ospringauf/espfan/fancontrol/wiring-diagram.png

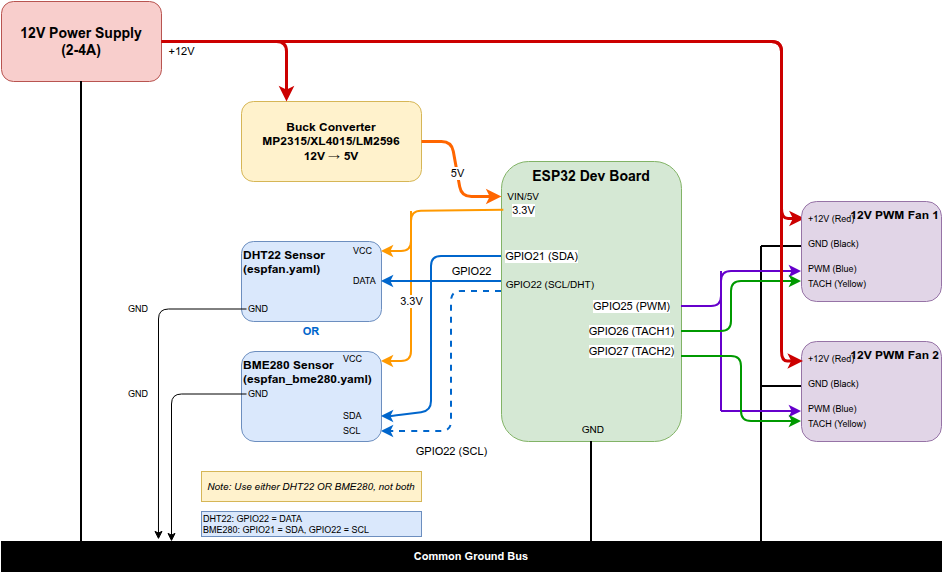
fancontrol/wiring-diagram.png
