ospringauf/espfan/(commit log)

2025-12-04 schematic added
2025-12-04 pwm offset
2025-12-07 fix bugs and update documentation
    [espfan.yaml]
2025-12-07 next devices
2025-12-10 change to other temp sensor
2025-12-16 after full assembly
2025-12-17 refactor and cleanup after test
    [espfan-circuit.kicad_pcb, espfan-circuit.kicad_sch]
